GHF/hfcs/README

hfcs - firmware for High Fructose
====
Xo Wang (http://www.geekshavefeelings.com)

About
-----
:D
