GHF/hfcs/hardware/High Fructose.brd

## EAGLE design hardware/High Fructose.brd (2013-02-17)

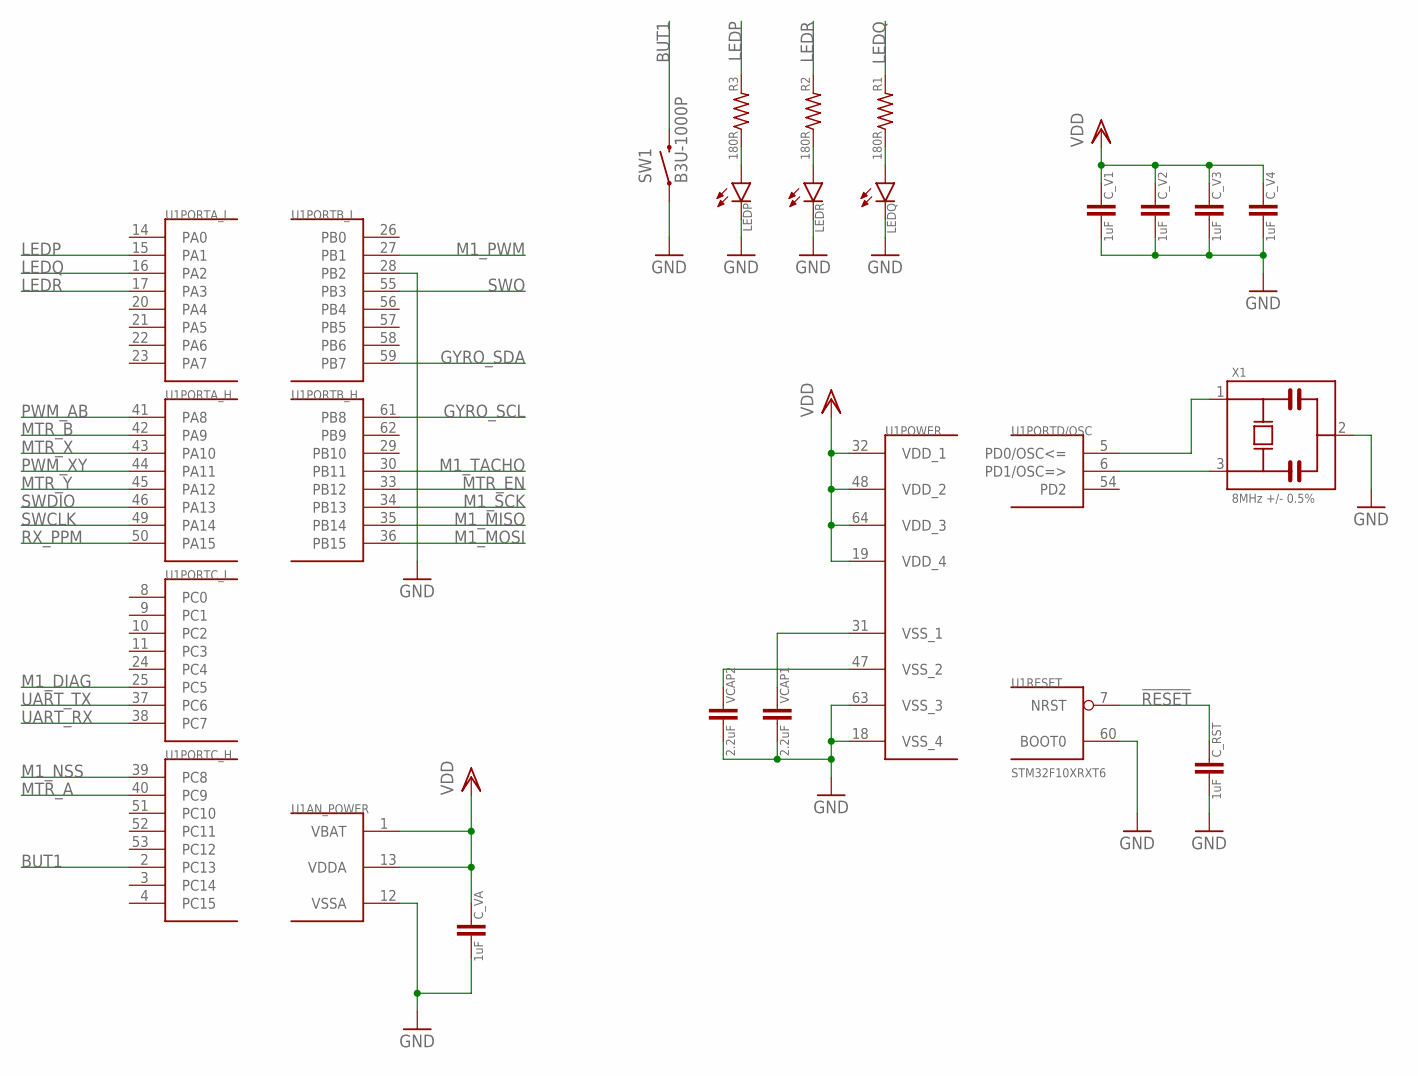
[picture p1: schematic High Fructose.sch, sheet 1]

Parts:
C_RST: 1uF; 0603
C_V1, C_V2, C_V3, C_V4: 1uF; 0603
C_VA: 1uF; 0603
LEDP: LED0805; 0805_POL
LEDQ: LED0805; 0805_POL
LEDR: LED0805; 0805_POL
R1, R2, R3: 180R; 0603
SW1: B3U-1000P
U1: STM32F10XRXT6; TQFP64
VCAP1, VCAP2: 2.2uF; 0603
X1: 8MHz +/- 0.5%; MURATA_CSTCE

Connections:
!RESET: C_RST.1, U1.7 (NRST); also elsewhere on the board
BUT1: SW1.2, U1.2 (PC13)
GND: C_RST.2, C_V1.2, C_V2.2, C_V3.2, C_V4.2, C_VA.2, LEDP.- (C), LEDQ.- (C), LEDR.- (C), SW1.1, U1.12 (VSSA), U1.18 (VSS_4), U1.28 (PB2), U1.60 (BOOT0), U1.63 (VSS_3), VCAP1.2, VCAP2.2, X1.2; also elsewhere on the board
GYRO_SCL: U1.61 (PB8); also elsewhere on the board
GYRO_SDA: U1.59 (PB7); also elsewhere on the board
LEDP: R3.2, U1.15 (PA1)
LEDQ: R1.2, U1.16 (PA2)
LEDR: R2.2, U1.17 (PA3)
M1_DIAG: U1.25 (PC5); also elsewhere on the board
M1_MISO: U1.35 (PB14); also elsewhere on the board
M1_MOSI: U1.36 (PB15); also elsewhere on the board
M1_NSS: U1.39 (PC8); also elsewhere on the board
M1_PWM: U1.27 (PB1); also elsewhere on the board
M1_SCK: U1.34 (PB13); also elsewhere on the board
M1_TACHO: U1.30 (PB11); also elsewhere on the board
MTR_A: U1.40 (PC9); also elsewhere on the board
MTR_B: U1.42 (PA9); also elsewhere on the board
MTR_EN: U1.33 (PB12); also elsewhere on the board
MTR_X: U1.43 (PA10); also elsewhere on the board
MTR_Y: U1.45 (PA12); also elsewhere on the board
unnamed: U1.6 (PD1/OSC=>), X1.3
unnamed: U1.5 (PD0/OSC<=), X1.1
unnamed: U1.47 (VSS_2), VCAP2.1
unnamed: U1.31 (VSS_1), VCAP1.1
unnamed: LEDQ.+ (A), R1.1
unnamed: LEDP.+ (A), R3.1
unnamed: LEDR.+ (A), R2.1
PWM_AB: U1.41 (PA8); also elsewhere on the board
PWM_XY: U1.44 (PA11); also elsewhere on the board
RX_PPM: U1.50 (PA15); also elsewhere on the board
SWCLK: U1.49 (PA14); also elsewhere on the board
SWDIO: U1.46 (PA13); also elsewhere on the board
SWO: U1.55 (PB3); also elsewhere on the board
UART_RX: U1.38 (PC7); also elsewhere on the board
UART_TX: U1.37 (PC6); also elsewhere on the board
VDD: C_V1.1, C_V2.1, C_V3.1, C_V4.1, C_VA.1, U1.1 (VBAT), U1.13 (VDDA), U1.19 (VDD_4), U1.32 (VDD_1), U1.48 (VDD_2), U1.64 (VDD_3); also elsewhere on the board

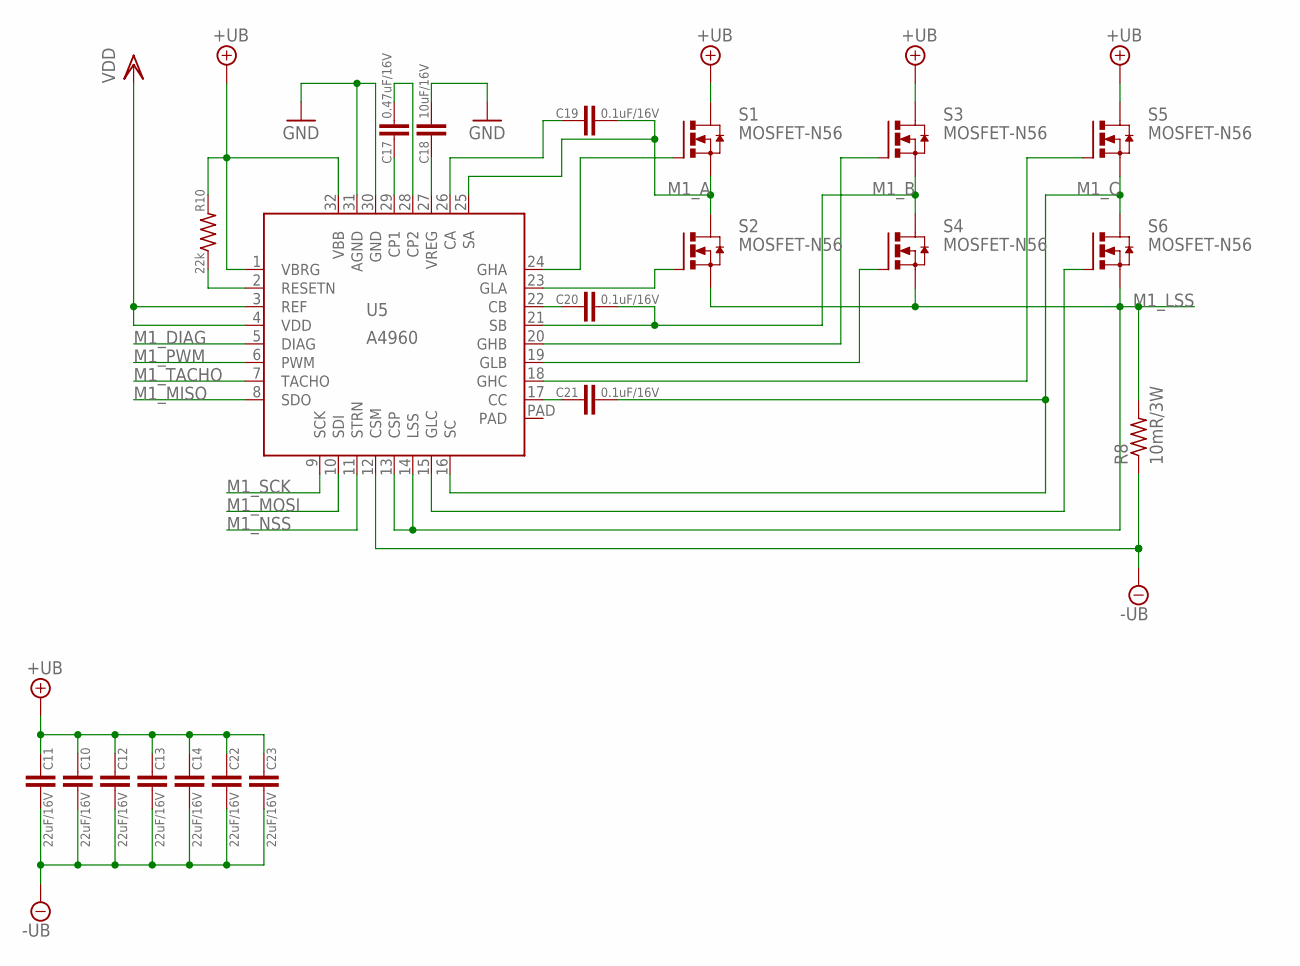
[picture p2: schematic High Fructose.sch, sheet 2]

Parts:
C10, C11, C12, C13, C14, C22, C23: 22uF/16V; 1206
C17: 0.47uF/16V; 0603
C18: 10uF/16V; 0805
C19, C20, C21: 0.1uF/16V; 0603
R8: 10mR/3W; R2512
R10: 22k; 0603
S1, S2, S3, S4, S5, S6: MOSFET-N56; SON-5X6
U5: A4960; LQFP32-THERMPAD

Connections:
+UB: C10.1, C11.1, C12.1, C13.1, C14.1, C22.1, C23.1, R10.2, S1.D, S3.D, S5.D, U5.1 (VBRG), U5.32 (VBB)
-UB: C10.2, C11.2, C12.2, C13.2, C14.2, C22.2, C23.2, R8.1, U5.12 (CSM)
GND: C18.2, U5.30 (GND), U5.31 (AGND); also elsewhere on the board
M1_A: C19.2, S1.S1 (S), S1.S2 (S), S1.S3 (S), S2.D, U5.25 (SA)
M1_B: C20.2, S3.S1 (S), S3.S2 (S), S3.S3 (S), S4.D, U5.21 (SB)
M1_C: C21.2, S5.S1 (S), S5.S2 (S), S5.S3 (S), S6.D, U5.16 (SC)
M1_DIAG: U5.5 (DIAG); also elsewhere on the board
M1_LSS: R8.2, S2.S1 (S), S2.S2 (S), S2.S3 (S), S4.S1 (S), S4.S2 (S), S4.S3 (S), S6.S1 (S), S6.S2 (S), S6.S3 (S), U5.13 (CSP), U5.14 (LSS)
M1_MISO: U5.8 (SDO); also elsewhere on the board
M1_MOSI: U5.10 (SDI); also elsewhere on the board
M1_NSS: U5.11 (STRN); also elsewhere on the board
M1_PWM: U5.6 (PWM); also elsewhere on the board
M1_SCK: U5.9 (SCK); also elsewhere on the board
M1_TACHO: U5.7 (TACHO); also elsewhere on the board
unnamed: C17.1, U5.29 (CP1)
unnamed: C17.2, U5.28 (CP2)
unnamed: C18.1, U5.27 (VREG)
unnamed: S1.G, U5.24 (GHA)
unnamed: S2.G, U5.23 (GLA)
unnamed: C19.1, U5.26 (CA)
unnamed: S3.G, U5.20 (GHB)
unnamed: S4.G, U5.19 (GLB)
unnamed: C20.1, U5.22 (CB)
unnamed: S5.G, U5.18 (GHC)
unnamed: S6.G, U5.15 (GLC)
unnamed: C21.1, U5.17 (CC)
unnamed: R10.1, U5.2 (RESETN)
VDD: U5.3 (REF), U5.4 (VDD); also elsewhere on the board

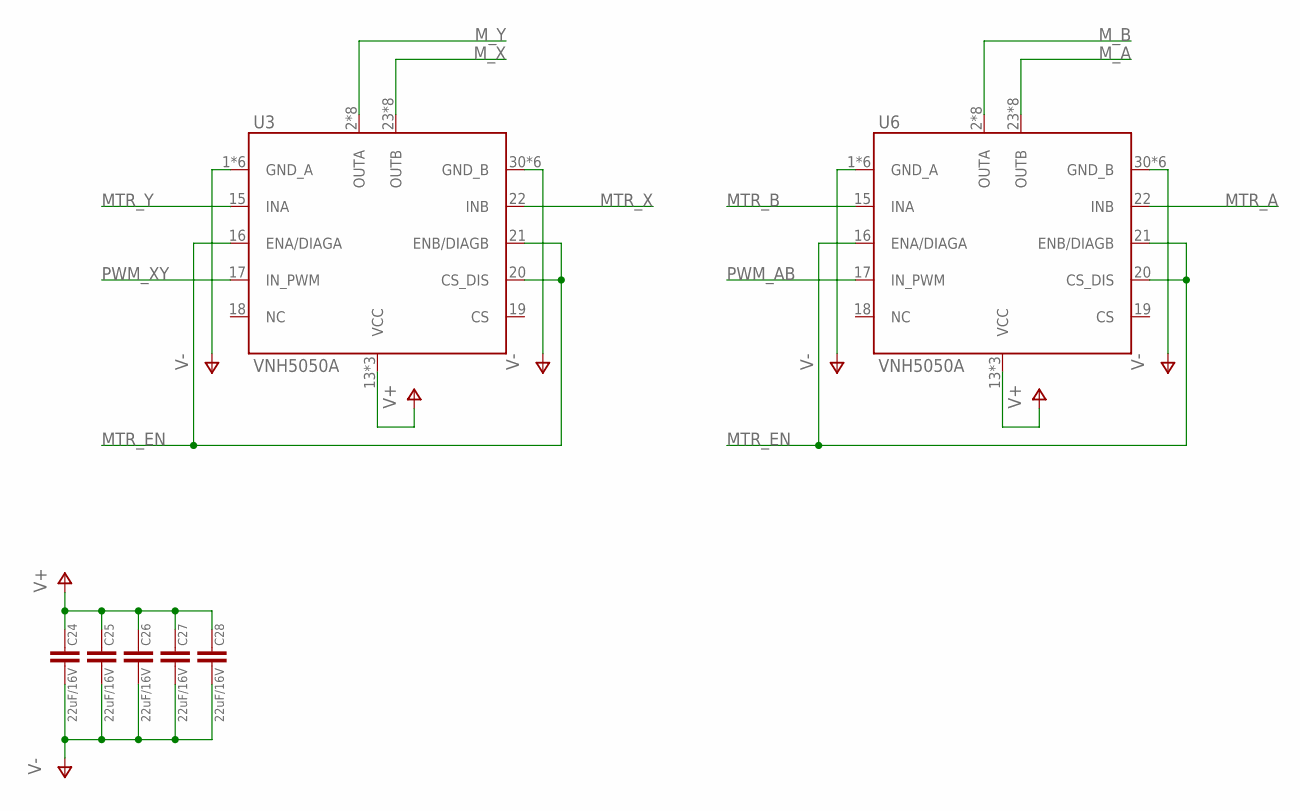
[picture p3: schematic High Fructose.sch, sheet 3]

Parts:
C24, C25, C26, C27, C28: 22uF/16V; 1206
U3, U6: VNH5050A; POWERSSO-36

Connections:
MTR_A: U6.22 (INB); also elsewhere on the board
MTR_B: U6.15 (INA); also elsewhere on the board
MTR_EN: U3.16 (ENA/DIAGA), U3.20 (CS_DIS), U3.21 (ENB/DIAGB), U6.16 (ENA/DIAGA), U6.20 (CS_DIS), U6.21 (ENB/DIAGB); also elsewhere on the board
MTR_X: U3.22 (INB); also elsewhere on the board
MTR_Y: U3.15 (INA); also elsewhere on the board
M_A: U6.23 (OUTB), U6.25 (OUTB), U6.26 (OUTB), U6.27 (OUTB), U6.28 (OUTB), U6.29 (OUTB), U6.35 (OUTB), U6.LS_B (OUTB)
M_B: U6.2 (OUTA), U6.8 (OUTA), U6.9 (OUTA), U6.10 (OUTA), U6.11 (OUTA), U6.12 (OUTA), U6.14 (OUTA), U6.LS_A (OUTA)
M_X: U3.23 (OUTB), U3.25 (OUTB), U3.26 (OUTB), U3.27 (OUTB), U3.28 (OUTB), U3.29 (OUTB), U3.35 (OUTB), U3.LS_B (OUTB)
M_Y: U3.2 (OUTA), U3.8 (OUTA), U3.9 (OUTA), U3.10 (OUTA), U3.11 (OUTA), U3.12 (OUTA), U3.14 (OUTA), U3.LS_A (OUTA)
PWM_AB: U6.17 (IN_PWM); also elsewhere on the board
PWM_XY: U3.17 (IN_PWM); also elsewhere on the board
V+: C24.1, C25.1, C26.1, C27.1, C28.1, U3.13 (VCC), U3.24 (VCC), U3.HS_AB (VCC), U6.13 (VCC), U6.24 (VCC), U6.HS_AB (VCC); also elsewhere on the board
V-: C24.2, C25.2, C26.2, C27.2, C28.2, U3.1 (GND_A), U3.3 (GND_A), U3.4 (GND_A), U3.5 (GND_A), U3.6 (GND_A), U3.7 (GND_A), U3.30 (GND_B), U3.31 (GND_B), U3.32 (GND_B), U3.33 (GND_B), U3.34 (GND_B), U3.36 (GND_B), U6.1 (GND_A), U6.3 (GND_A), U6.4 (GND_A), U6.5 (GND_A), U6.6 (GND_A), U6.7 (GND_A), U6.30 (GND_B), U6.31 (GND_B), U6.32 (GND_B), U6.33 (GND_B), U6.34 (GND_B), U6.36 (GND_B); also elsewhere on the board

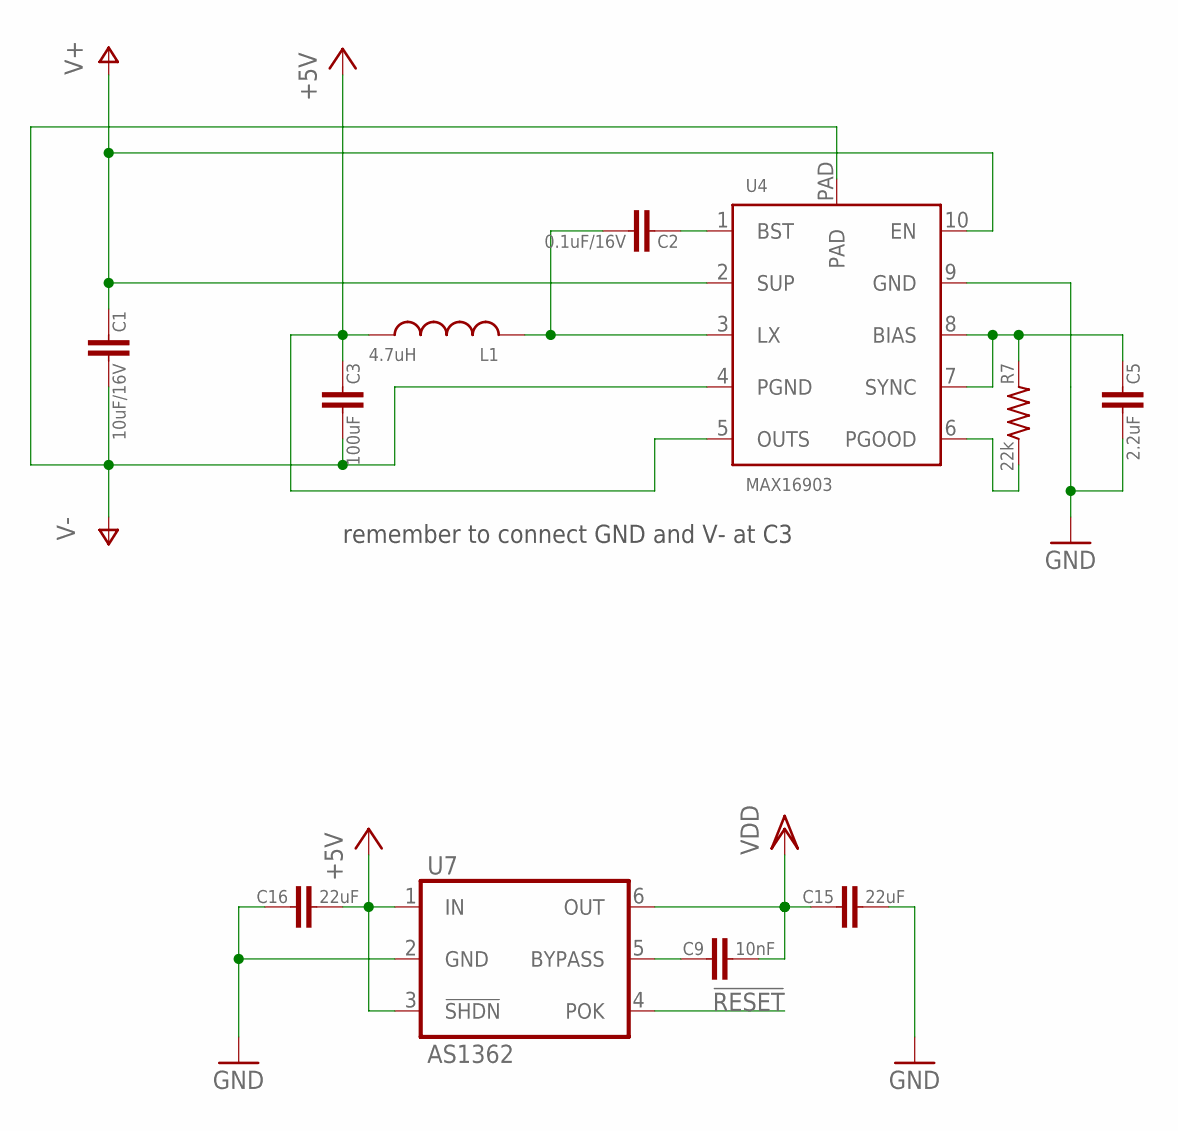
[picture p4: schematic High Fructose.sch, sheet 4]

Parts:
C1: 10uF/16V; 0805
C2: 0.1uF/16V; 0603
C3: 100uF; 1206
C5: 2.2uF; 0603
C9: 10nF; 0603
C15, C16: 22uF; 0805
L1: 4.7uH; TAIYO-YUDEN_NR30
R7: 22k; 0603
U4: MAX16903; TDFN-10
U7: AS1362; SOT23-6

Connections:
!RESET: U7.4 (POK); also elsewhere on the board
+5V: C3.1, C16.2, L1.1, U4.5 (OUTS), U7.1 (IN), U7.3 (!SHDN); also elsewhere on the board
GND: C5.2, C15.2, C16.1, U4.9 (GND), U7.2 (GND); also elsewhere on the board
unnamed: C2.1, U4.1 (BST)
unnamed: C9.1, U7.5 (BYPASS)
unnamed: C2.2, L1.2, U4.3 (LX)
unnamed: C5.1, R7.2, U4.7 (SYNC), U4.8 (BIAS)
unnamed: R7.1, U4.6 (PGOOD)
V+: C1.1, U4.2 (SUP), U4.10 (EN); also elsewhere on the board
V-: C1.2, C3.2, U4.4 (PGND), U4.PAD; also elsewhere on the board
VDD: C9.2, C15.1, U7.6 (OUT); also elsewhere on the board

Notes on the sheet:
remember to connect GND and V- at C3

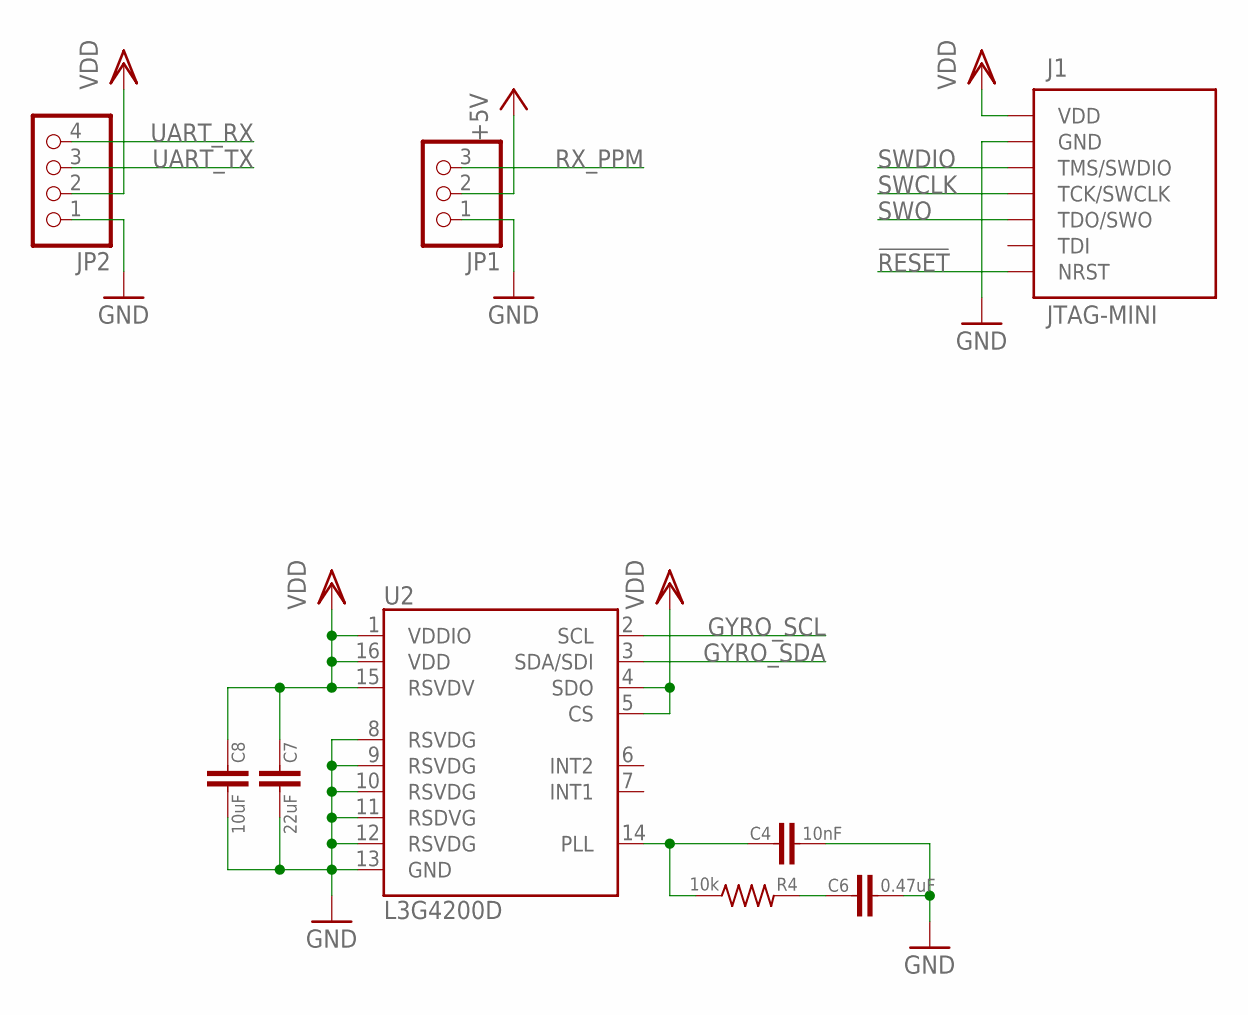
[picture p5: schematic High Fructose.sch, sheet 5]

Parts:
C4: 10nF; 0603
C6: 0.47uF; 0603
C7: 22uF; 0805
C8: 10uF; 0603
J1: JTAG-MINI
JP1: PINHD-1X03_2.54-S; 1X03-S
JP2: PINHD-1X04_2.54-S; 1X04-S
R4: 10k; 0603
U2: L3G4200D; LGA16-4X4

Connections:
!RESET: J1.NRST; also elsewhere on the board
+5V: JP1.2; also elsewhere on the board
GND: C4.2, C6.2, C7.2, C8.2, J1.GND1 (GND), J1.GND2 (GND), J1.GND3 (GND), J1.GND4 (GND), JP1.1, JP2.1, U2.8 (RSVDG), U2.9 (RSVDG), U2.10 (RSVDG), U2.11 (RSDVG), U2.12 (RSVDG), U2.13 (GND); also elsewhere on the board
GYRO_SCL: U2.2 (SCL); also elsewhere on the board
GYRO_SDA: U2.3 (SDA/SDI); also elsewhere on the board
unnamed: C4.1, R4.1, U2.14 (PLL)
unnamed: C6.1, R4.2
RX_PPM: JP1.3; also elsewhere on the board
SWCLK: J1.TCK (TCK/SWCLK); also elsewhere on the board
SWDIO: J1.TMS (TMS/SWDIO); also elsewhere on the board
SWO: J1.TDO (TDO/SWO); also elsewhere on the board
UART_RX: JP2.4; also elsewhere on the board
UART_TX: JP2.3; also elsewhere on the board
VDD: C7.1, C8.1, J1.VDD, JP2.2, U2.1 (VDDIO), U2.4 (SDO), U2.5 (CS), U2.15 (RSVDV), U2.16 (VDD); also elsewhere on the board

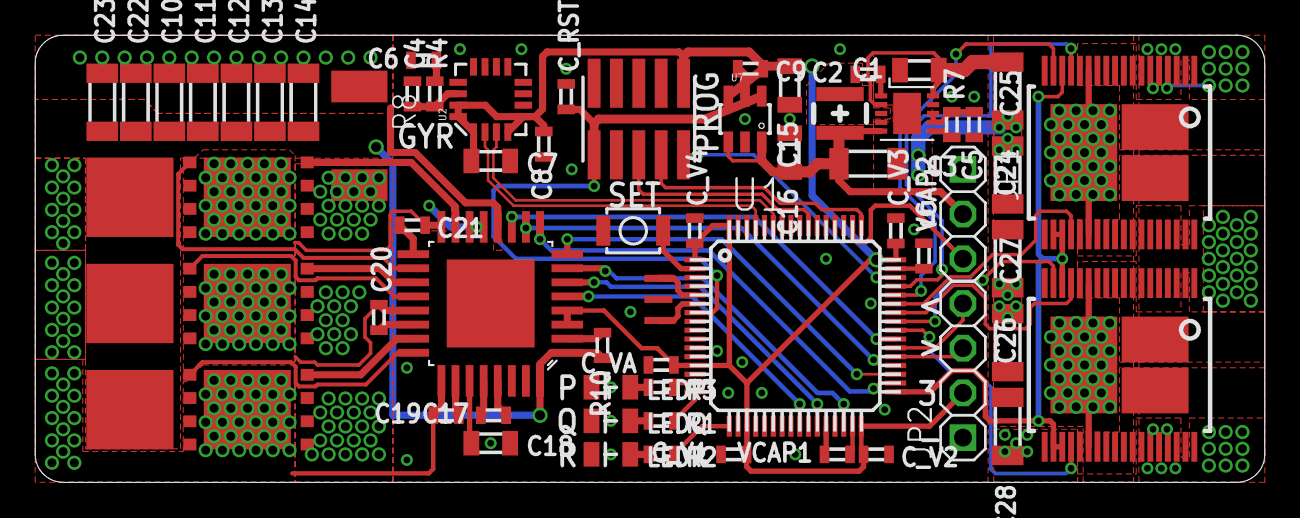
[picture p6: board High Fructose.brd from above]

Board: 2 copper layers, 69.8 x 25.4 mm, 65 parts (0 on the bottom side), 69 nets.
