GHF/hfcs/(commit log)

2013-02-08 Importing Gyro King code and latest ChibiOS 2.4.x
    [Tortilla.brd, Tortilla.sch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]
2013-02-10 Add VNH5050A drivers, fix some minor issues
    [A4960.h, VNH5050A.cpp, VNH5050A.h, main.cpp]
2013-02-17 Add deadband range mapping and fix Makefile
    [A4960.cpp, HFCS.cpp, HFCS.h]
2013-02-17 Update hardware dir with High Fructose
    [High Fructose.brd, High Fructose.sch, Tortilla.brd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]
2013-08-13 Ignore A4960 fault signal; tighten up failsafe loop
    [HFCS.cpp]
2013-08-21 Add code to read L3GD20 gyro
2013-08-21 Use LEDR as main loop duty cycle indicator
2013-08-22 Clean up L3GD20, add error flag set by I2C comm errors
    [L3GD20.cpp, L3GD20.h, main.cpp]
2013-08-22 Separate motor control into functions based on failsafe state and gyro enable state
    [HFCS.cpp, HFCS.h]
2013-08-22 Add PID library and glue code
2013-08-22 Add gyro bias recording to initialization
2013-08-22 Add and tune gyro z-axis control, tighten loop to 200Hz, and add deadband for motor PWM
    [HFCS.cpp, HFCS.h]
